desmondcheongzx/SpaceMaker-Bot/images/mount1.jpg

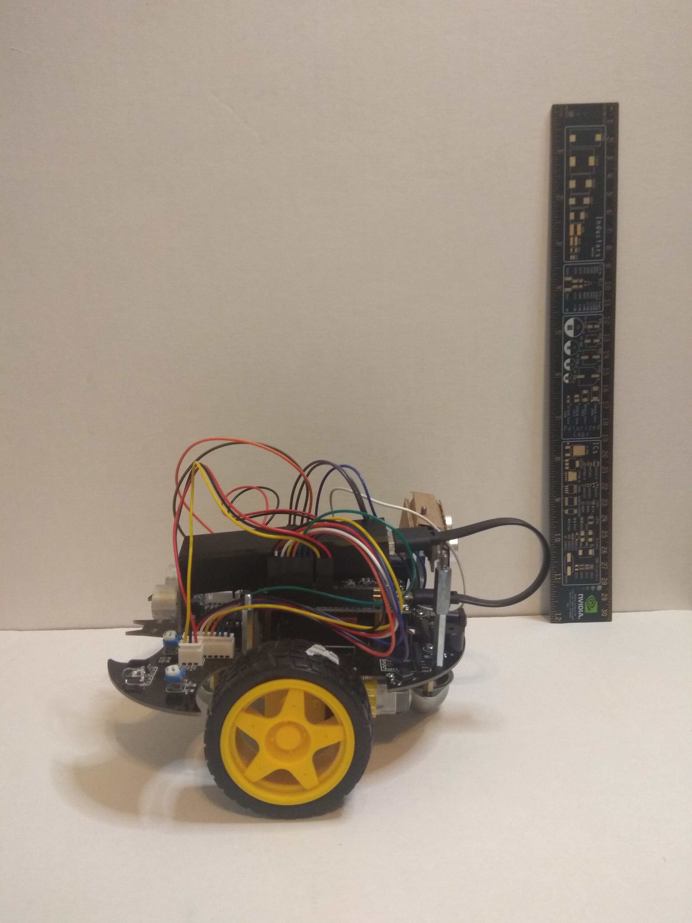
images/mount1.jpg
