desmondcheongzx/SpaceMaker-Bot/images/mount3.jpg

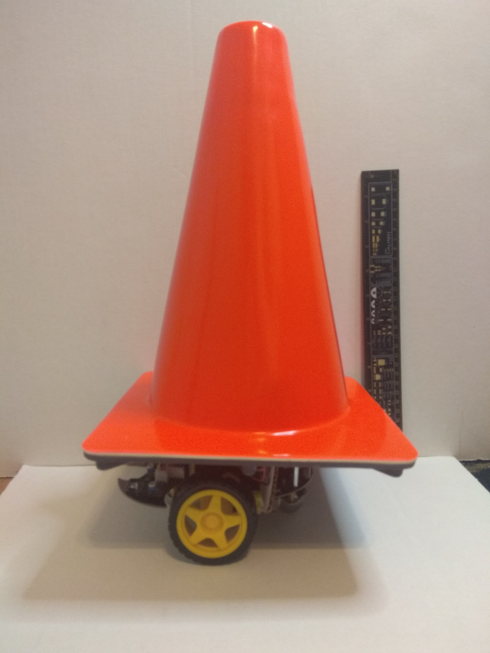
images/mount3.jpg
