desmondcheongzx/SpaceMaker-Bot/(commit log)

2020-10-26 Upload image of mounts with varying heights
2020-10-26 Add gantry video
2020-10-26 Add lasercut files and images
2020-10-28 Update README.md
    Resolved known bugs which was caused by certain pins preventing the Arduino boards from communicating with the programmer, so this section is being removed from the README.
2020-11-22 Switch right wheel pins
2020-12-02 Add final prototype images
2020-12-02 Upload gif of wireless control
2020-12-02 Reorganise wireless movement gif location
